ewanuno/tr707_negative_vibes/tr707minus10v_kicad/tr707minus10v_kicad_front.png

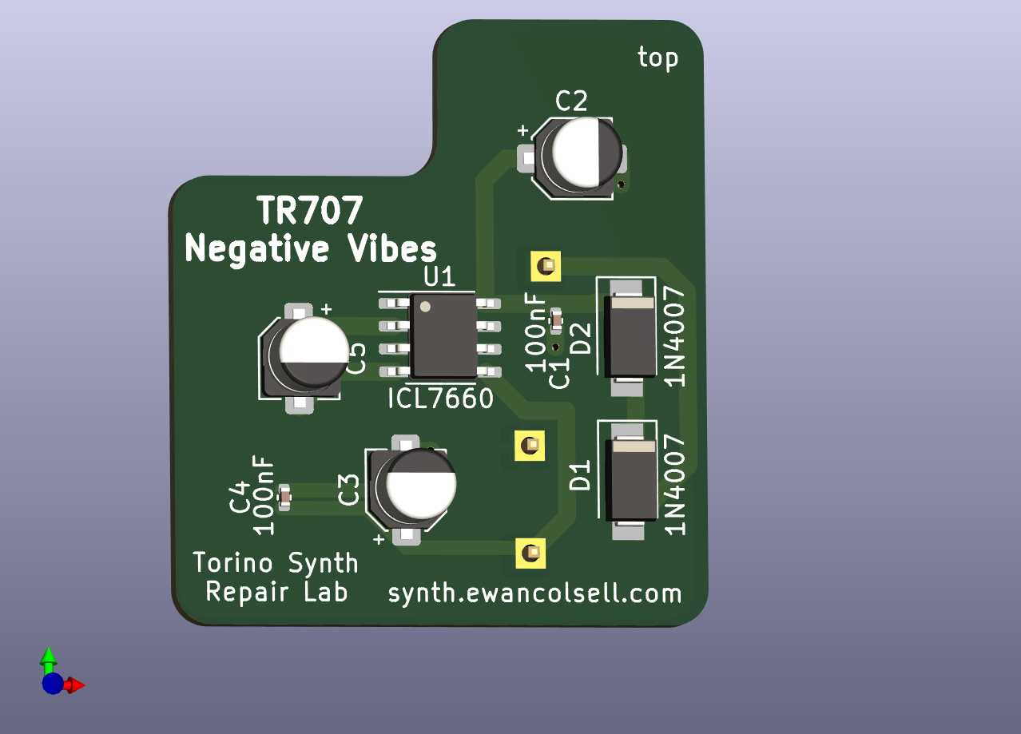
tr707minus10v_kicad/tr707minus10v_kicad_front.png
