ewanuno/tr707_negative_vibes/tr707minus10v_kicad/tr707minus10v_kicad.pdf

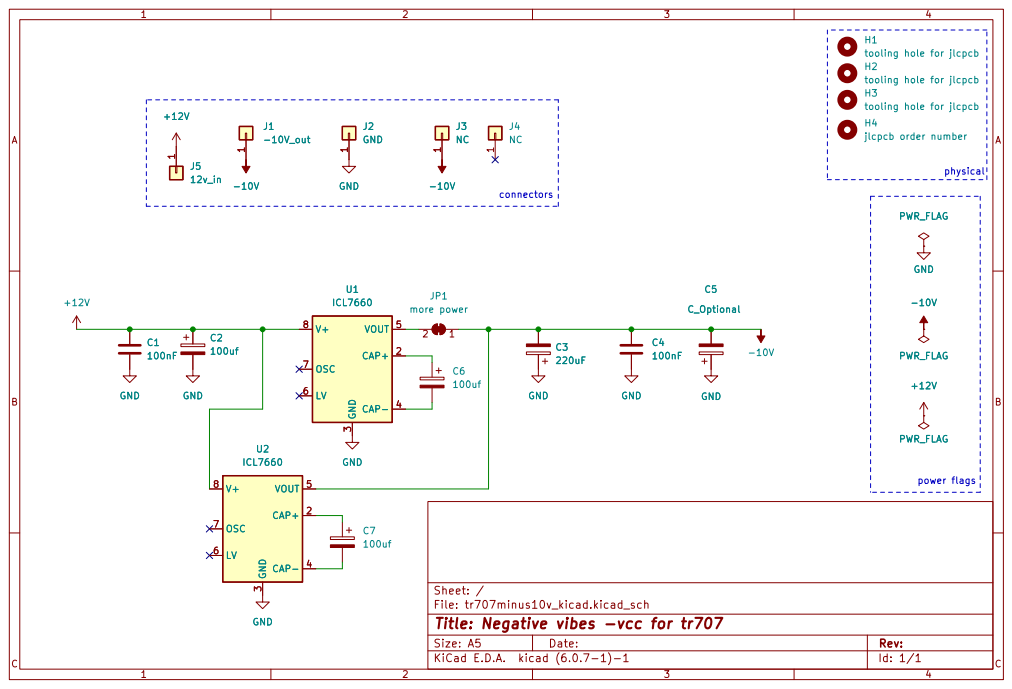
[picture p6: page 1]

tooling hole for jlcpcb H3
tooling hole for jlcpcb H2

File: tr707minus10v_kicad.kicad_sch Sheet: /
Id: 1/1 Title: Negative vibes -vcc for tr707
