ewanuno/tr707_negative_vibes/(threads)

Thread 1 (2022-12-10):

silkscreen error

ewanuno, 2022-12-10:
error in the silkscreen,

top layer NC for the bottom right pin should be -vout

ewanuno, 2022-12-10:
fixed by https://github.com/ewanuno/tr707_negative_vibes/commit/644d2c4a0139f87692b890e21d632f29da1940f6

Closed 2022-12-10.
