ewanuno/tr707_negative_vibes/(commit log)

2022-07-26 add kicad project
    [tr707minus10v_kicad-CuBottom.gbr, tr707minus10v_kicad-CuTop.gbr, tr707minus10v_kicad-EdgeCuts.gbr, tr707minus10v_kicad-MaskBottom.gbr, tr707minus10v_kicad-MaskTop.gbr, tr707minus10v_kicad-NPTH.drl, tr707minus10v_kicad-PTH.drl, tr707minus10v_kicad-PasteBottom.gbr]
2022-07-26 change board outline
    prototypes just arrived, working but pcb touches a component.
    changed board outline to avoid touching Capacitor C5
    [tr707minus10v_kicad.kicad_pcb]
2022-07-26 fix pin spacing to fit better
    [tr707minus10v_kicad.kicad_pcb]
2022-07-27 more pins..
    add some more (nc) pins for mechanical stability
    [tr707minus10v_kicad.kicad_pcb, tr707minus10v_kicad.kicad_sch]
2022-07-29 add a version number
    [tr707minus10v_kicad.kicad_pcb]
2022-09-05 started adding a second icl7660
    after testing the prototypes it was found that the voltage drop is too much, the output voltage is around 8.5v which actually works in a tr707, but it could be better.
    acording to the intersill datasheet, you can just add another icl7660 in parallel to reduce voltage drop, lets try it.
    also changed to the ceramic caps from 0402 to 1203
    updated the schematic and pcb
    [tr707minus10v_kicad-CuBottom.gbr, tr707minus10v_kicad-CuTop.gbr, tr707minus10v_kicad-EdgeCuts.gbr, tr707minus10v_kicad-MaskBottom.gbr, tr707minus10v_kicad-MaskTop.gbr, tr707minus10v_kicad-NPTH.drl, tr707minus10v_kicad-PTH.drl, tr707minus10v_kicad-PasteBottom.gbr]
2022-09-15 jlcpcb stuff
    add grid origin and tool grid origin to PCB, jlcpcb web preview was going crazy
    also fix the rotation of IC1
    [tr707minus10v_kicad-CuBottom.gbr, tr707minus10v_kicad-CuTop.gbr, tr707minus10v_kicad-EdgeCuts.gbr, tr707minus10v_kicad-MaskTop.gbr, tr707minus10v_kicad-NPTH.drl, tr707minus10v_kicad-PTH.drl, tr707minus10v_kicad-PasteBottom.gbr, tr707minus10v_kicad-PasteTop.gbr]
2022-09-26 ext caps and silkscreen cleanup
    added optional external THT capacitors,
    clean up silk screen
    [tr707minus10v_kicad.kicad_pcb, tr707minus10v_kicad.kicad_sch]
2022-09-30 fixed capacitor orientations
    electrolytic capacitors c6 and c3 were the wrong way around.
    surprised it took so long for me to notice!
    [tr707minus10v_kicad.kicad_pcb, tr707minus10v_kicad.kicad_sch]
2022-09-30 Update tr707minus10v_kicad.kicad_sch
    remove diodes, the diode on the tr707 pcb is enough
    [tr707minus10v_kicad.kicad_sch]
2022-09-30 remove c6 change c3 to 220v
    remove superflous capacitor and uprate c3 to 220uf (was 100uf)
    [tr707minus10v_kicad.kicad_pcb, tr707minus10v_kicad.kicad_sch]
2022-10-13 Big rework.
    re-added a m7 diode with a jumper to drop the voltage if required (incase the other improvements work TOO well)
    increase value of charge pump capacitors to increase output voltage.
    added a seccond
    bigger output capacitor removes a bit more ripple. (a footprint for a THT capacitor is also provided)
    respin PCB
    to accomodate all the above the pcb size is increased.
    [tr707minus10v_kicad-CuBottom.gbr, tr707minus10v_kicad-CuTop.gbr, tr707minus10v_kicad-EdgeCuts.gbr, tr707minus10v_kicad-MaskBottom.gbr, tr707minus10v_kicad-MaskTop.gbr, tr707minus10v_kicad-NPTH.drl, tr707minus10v_kicad-PTH.drl, tr707minus10v_kicad-PasteBottom.gbr]
2022-10-13 jlcpcb stuff and round traces
    [tr707minus10v_kicad-CuBottom.gbr, tr707minus10v_kicad-CuTop.gbr, tr707minus10v_kicad-EdgeCuts.gbr, tr707minus10v_kicad-MaskBottom.gbr, tr707minus10v_kicad-MaskTop.gbr, tr707minus10v_kicad-NPTH.drl, tr707minus10v_kicad-PTH.drl, tr707minus10v_kicad-PasteBottom.gbr]
2022-10-13 update board photos
2022-10-13 add jumper for seccond icl7660
    [tr707minus10v_kicad.kicad_pcb, tr707minus10v_kicad.kicad_sch]
2022-10-13 clean up silkscreen - new pics
    [tr707minus10v_kicad.kicad_sch]
2022-11-03 jp2 should be a closed jumper
    change jp2 footprint
    [tr707minus10v_kicad-CuBottom.gbr, tr707minus10v_kicad-CuTop.gbr, tr707minus10v_kicad-EdgeCuts.gbr, tr707minus10v_kicad-MaskBottom.gbr, tr707minus10v_kicad-MaskTop.gbr, tr707minus10v_kicad-NPTH.drl, tr707minus10v_kicad-PTH.drl, tr707minus10v_kicad-PasteBottom.gbr]
2022-11-04 jp2 fix for real this time...
    jp2
    [tr707minus10v_kicad.kicad_pcb]
2022-11-04 add tooling holes and order number for jlcpcb
    [tr707minus10v_kicad.kicad_pcb]
2022-11-04 remove D1 and JP1
    remove D1 and Jp1, they are not needed.
    [tr707minus10v_kicad.kicad_pcb, tr707minus10v_kicad.kicad_sch]
2022-11-04 added tooling and order no. to schematic
    update pcb was removing the tooling holes and order no. so i added them as symbols to the schematic.
    [tr707minus10v_kicad.kicad_pcb, tr707minus10v_kicad.kicad_sch]
2022-11-04 clean up schematic
    [tr707minus10v_kicad.kicad_sch]
2022-11-04 nudge +vin connector
    pcb was sitting slightly askew on the tr707
    [tr707minus10v_kicad.kicad_pcb, tr707minus10v_kicad.kicad_sch]
2022-11-04 connect j3 to -10v
    connect j3 to -10v
    [tr707minus10v_kicad.kicad_pcb, tr707minus10v_kicad.kicad_sch]
2022-11-10 cleanup for production
    [tr707minus10v_kicad-CuBottom.gbr, tr707minus10v_kicad-CuTop.gbr, tr707minus10v_kicad-EdgeCuts.gbr, tr707minus10v_kicad-MaskBottom.gbr, tr707minus10v_kicad-MaskTop.gbr, tr707minus10v_kicad-NPTH.drl, tr707minus10v_kicad-PTH.drl, tr707minus10v_kicad-PasteBottom.gbr]
2022-12-10 fixed silkscreen error
    changed NC to - VOUT
    [tr707minus10v_kicad.kicad_pcb]
2022-12-17 board outline and version number 2.1
    change board outline slightly to stop it touching the cartridge socket, and leave a bit more space for the capacitors on some tr707 pcb versions
    [tr707minus10v_kicad.kicad_pcb]
2022-12-17 v2.2
    should have been 2.2
    [tr707minus10v_kicad.kicad_pcb]
2022-12-17 remove extra version numbers on silkscreen
    [tr707minus10v_kicad.kicad_pcb]
